GadgetReboot/ADS1115_16ch/README.md

# ADS1115_16ch
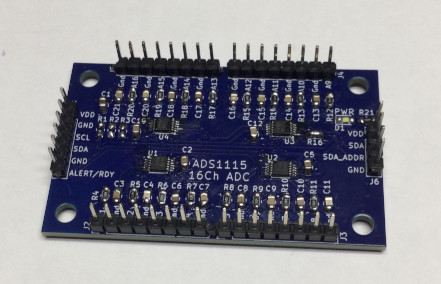
[picture p1: Assembled_PCB.jpg]
PCB
<br><br><BR><BR>
Four ADS1115 16 bit ADCs on one pcb for up to 16 channels on a single I2C bus
