GadgetReboot/ADS1115_16ch/Sch_ADS1115_16ch.pdf

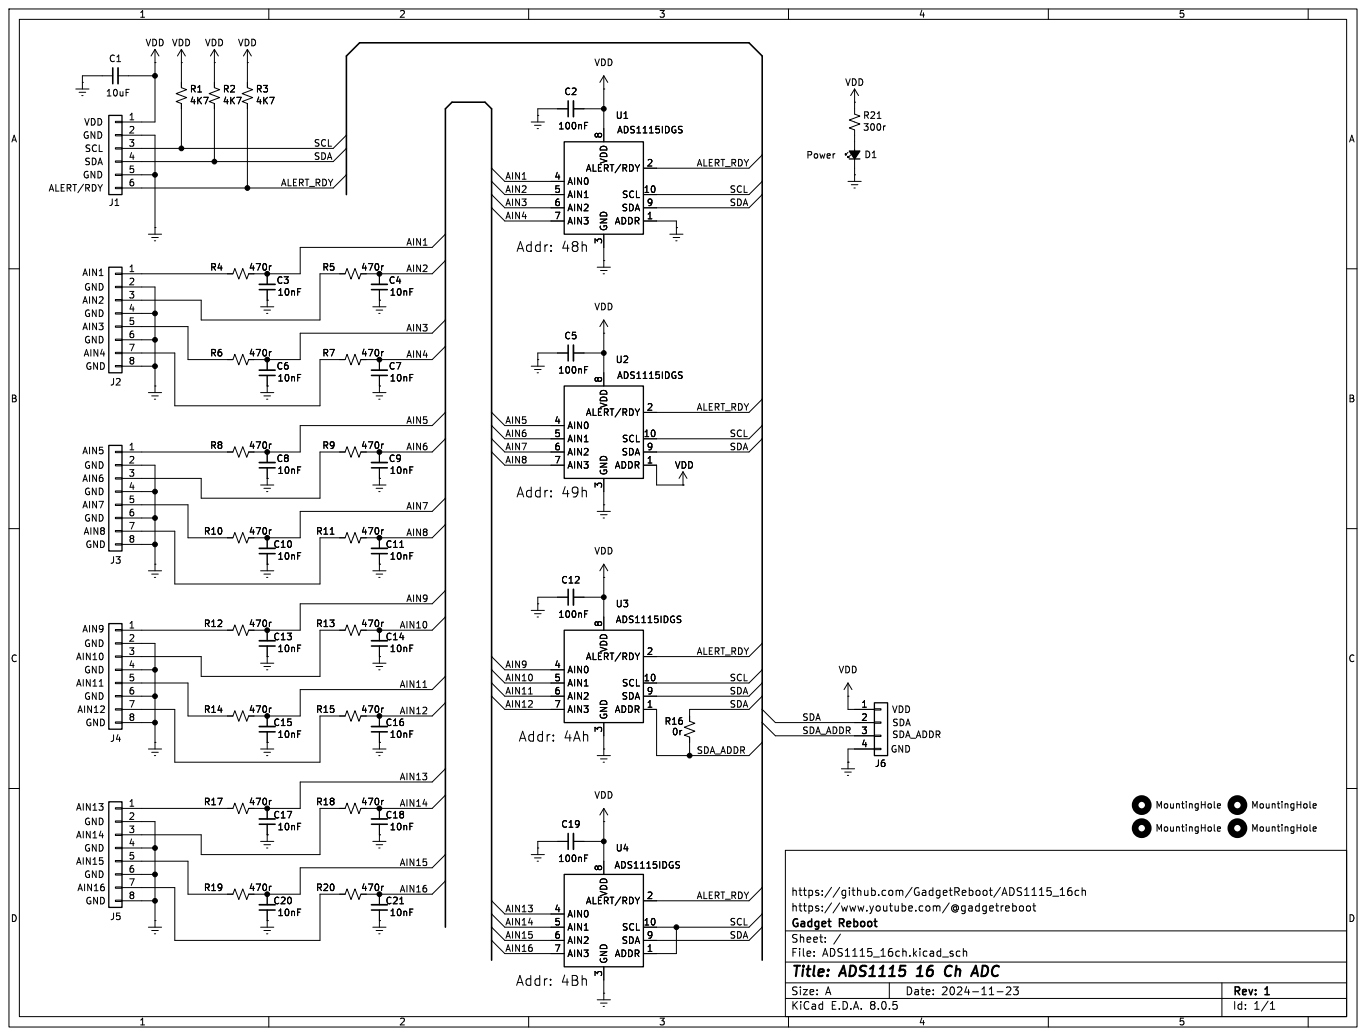
[picture p2: page 1]

https://github.com/GadgetReboot/ADS1115_16ch VDD

Id: 1/1 Title: ADS1115 16 Ch ADC
