GadgetReboot/ADS1115_16ch/KiCad/ADS1115_16ch.kicad_pcb

## KiCad design KiCad/ADS1115_16ch.kicad_pcb (2025-01-21)

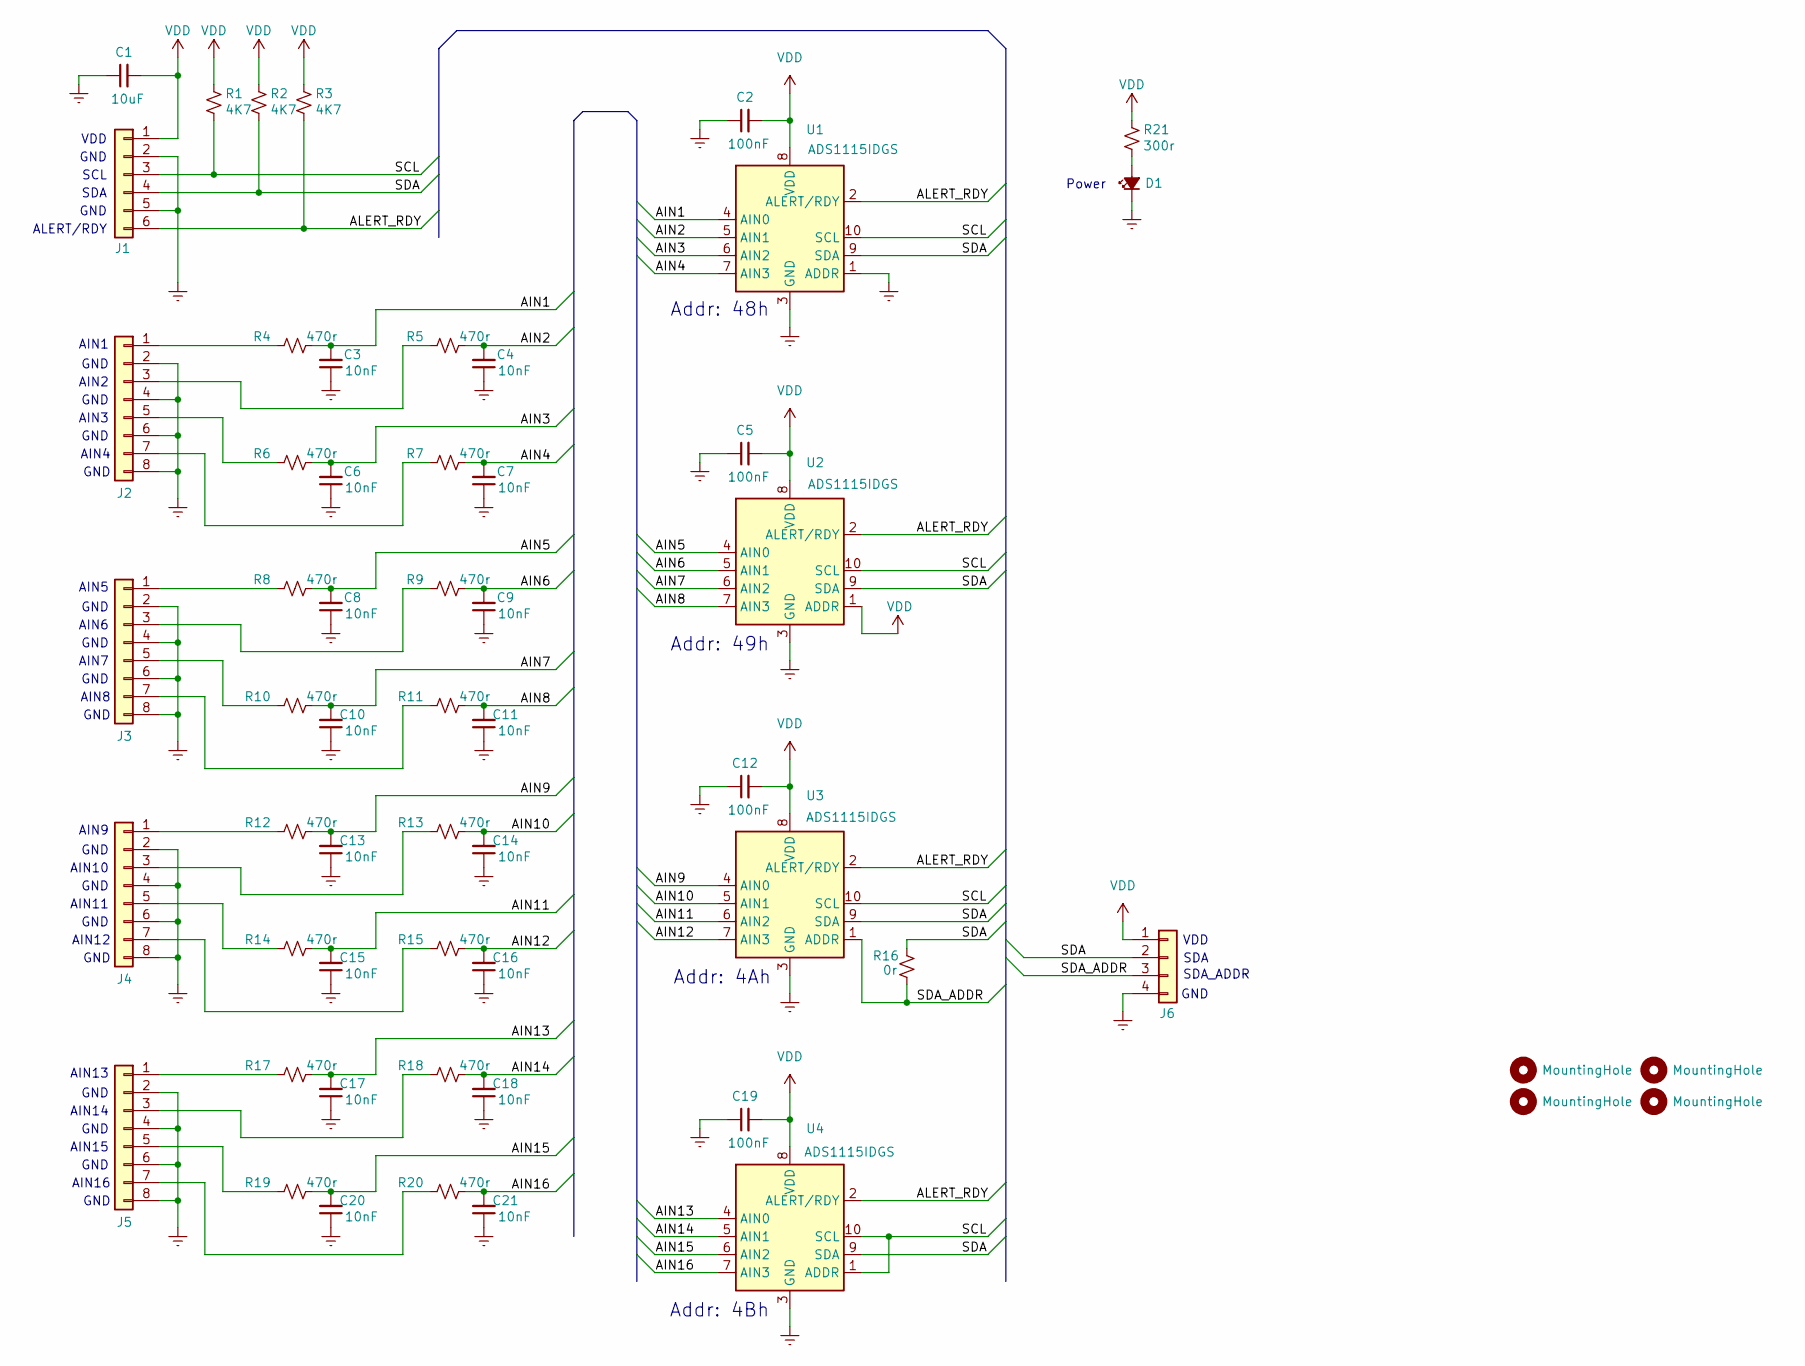
[picture p3: schematic ADS1115_16ch.kicad_sch, ADS1115 16 Ch ADC]

Parts:
C1: 10uF; C_0805_2012Metric_Pad1.18x1.45mm_HandSolder
C2, C5, C12, C19: 100nF; C_0805_2012Metric_Pad1.18x1.45mm_HandSolder
C3, C4, C6, C7, C8, C9, C10, C11, C13, C14, C15, C16, C17, C18, C20, C21: 10nF; C_0805_2012Metric_Pad1.18x1.45mm_HandSolder
D1: LED_Small_Filled; LED_0805_2012Metric_Pad1.15x1.40mm_HandSolder
H1, H2, H3, H4: MountingHole; MountingHole_3.5mm
J1: Conn_01x06; PinHeader_1x06_P2.54mm_Vertical
J2, J3, J4, J5: Conn_01x08; PinHeader_1x08_P2.54mm_Vertical
J6: Conn_01x04; PinHeader_1x04_P2.54mm_Vertical
R1, R2, R3: 4K7; R_0805_2012Metric_Pad1.20x1.40mm_HandSolder
R4, R5, R6, R7, R8, R9, R10, R11, R12, R13, R14, R15, R17, R18, R19, R20: 470r; R_0805_2012Metric_Pad1.20x1.40mm_HandSolder
R16: 0r; R_0805_2012Metric_Pad1.20x1.40mm_HandSolder
R21: 300r; R_0805_2012Metric_Pad1.20x1.40mm_HandSolder
U1, U2, U3, U4: ADS1115IDGS; TSSOP-10_3x3mm_P0.5mm

Connections:
/AIN1: C3.2, R4.2, U1.4 (AIN0)
/AIN2: C4.2, R5.2, U1.5 (AIN1)
/AIN3: C6.2, R6.2, U1.6 (AIN2)
/AIN4: C7.2, R7.2, U1.7 (AIN3)
/AIN5: C8.2, R8.2, U2.4 (AIN0)
/AIN6: C9.2, R9.2, U2.5 (AIN1)
/AIN7: C10.2, R10.2, U2.6 (AIN2)
/AIN8: C11.2, R11.2, U2.7 (AIN3)
/AIN9: C13.2, R12.2, U3.4 (AIN0)
/AIN10: C14.2, R13.2, U3.5 (AIN1)
/AIN11: C15.2, R14.2, U3.6 (AIN2)
/AIN12: C16.2, R15.2, U3.7 (AIN3)
/AIN13: C17.2, R17.2, U4.4 (AIN0)
/AIN14: C18.2, R18.2, U4.5 (AIN1)
/AIN15: C20.2, R19.2, U4.6 (AIN2)
/AIN16: C21.2, R20.2, U4.7 (AIN3)
/ALERT_RDY: J1.6, R3.2, U1.2 (ALERT/RDY), U2.2 (ALERT/RDY), U3.2 (ALERT/RDY), U4.2 (ALERT/RDY)
/SCL: J1.3, R1.2, U1.10 (SCL), U2.10 (SCL), U3.10 (SCL), U4.1 (ADDR), U4.10 (SCL)
/SDA: J1.4, J6.2, R2.2, R16.2, U1.9 (SDA), U2.9 (SDA), U3.9 (SDA), U4.9 (SDA)
/SDA_ADDR: J6.3, R16.1, U3.1 (ADDR)
GNDREF: C1.1, C2.1, C3.1, C4.1, C5.1, C6.1, C7.1, C8.1, C9.1, C10.1, C11.1, C12.1, C13.1, C14.1, C15.1, C16.1, C17.1, C18.1, C19.1, C20.1, C21.1, D1.1 (K), J1.2, J1.5, J2.2, J2.4, J2.6, J2.8, J3.2, J3.4, J3.6, J3.8, J4.2, J4.4, J4.6, J4.8, J5.2, J5.4, J5.6, J5.8, J6.4, U1.1 (ADDR), U1.3 (GND), U2.3 (GND), U3.3 (GND), U4.3 (GND)
unnamed: D1.2 (A), R21.2
unnamed: J2.1, R4.1
unnamed: J2.3, R5.1
unnamed: J2.5, R6.1
unnamed: J2.7, R7.1
unnamed: J3.1, R8.1
unnamed: J3.3, R9.1
unnamed: J3.5, R10.1
unnamed: J3.7, R11.1
unnamed: J4.1, R12.1
unnamed: J4.3, R13.1
unnamed: J4.5, R14.1
unnamed: J4.7, R15.1
unnamed: J5.1, R17.1
unnamed: J5.3, R18.1
unnamed: J5.5, R19.1
unnamed: J5.7, R20.1
VDD: C1.2, C2.2, C5.2, C12.2, C19.2, J1.1, J6.1, R1.1, R2.1, R3.1, R21.1, U1.8 (VDD), U2.1 (ADDR), U2.8 (VDD), U3.8 (VDD), U4.8 (VDD)

Notes on the sheet:
GND
AIN14
AIN7
SDA_ADDR
SCL
AIN13
AIN11
Addr: 4Bh
AIN3
Addr: 48h
Addr: 49h
ALERT/RDY
AIN15
AIN10
AIN8
AIN16
AIN4
VDD
AIN9
AIN6
AIN2
Power
Addr: 4Ah
AIN12
SDA
AIN1
AIN5

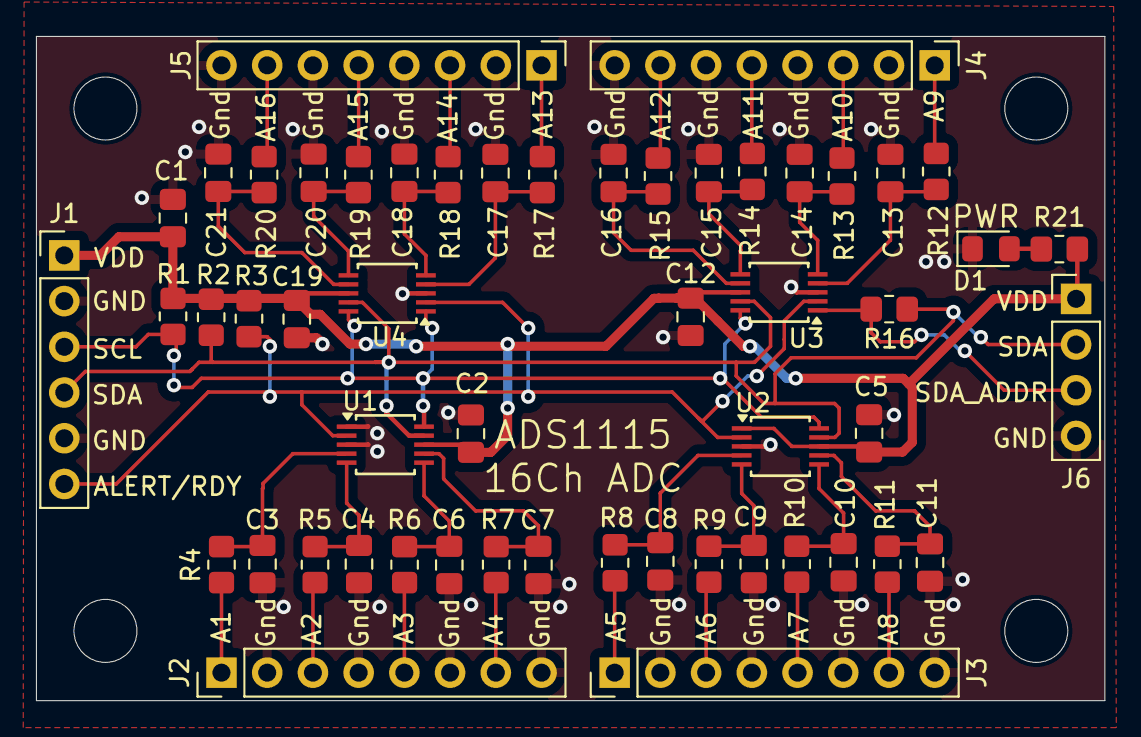
[picture p4: board ADS1115_16ch.kicad_pcb from above]

Board: 2 copper layers, 59.4 x 36.9 mm, 57 parts (0 on the bottom side), 39 nets.
